GrayWolf8856/kyletechcorner-preview/projects/plant-hub/img/render-iso.png

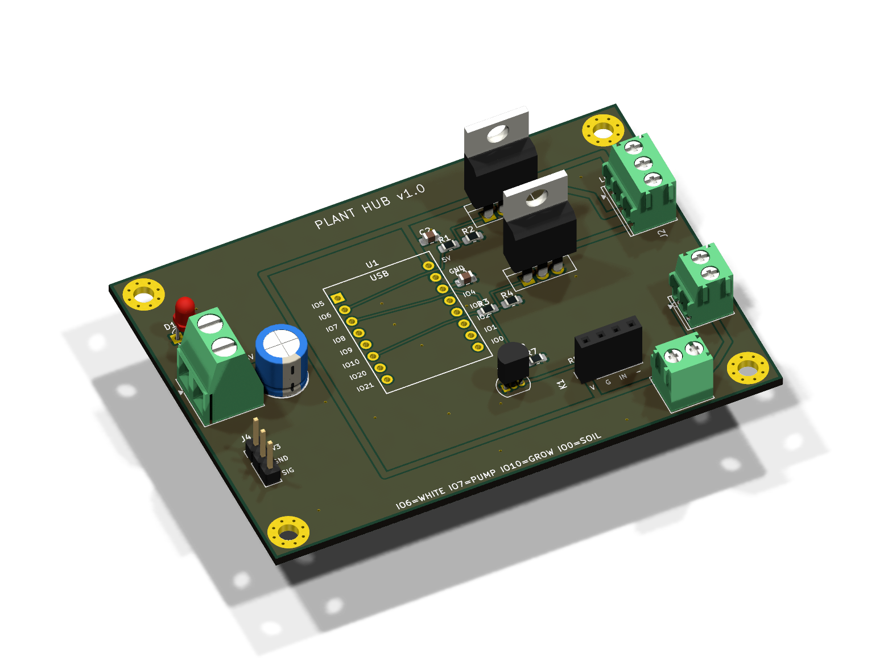
projects/plant-hub/img/render-iso.png
