GrayWolf8856/kyletechcorner-preview/projects/plant-hub/img/render-top.png

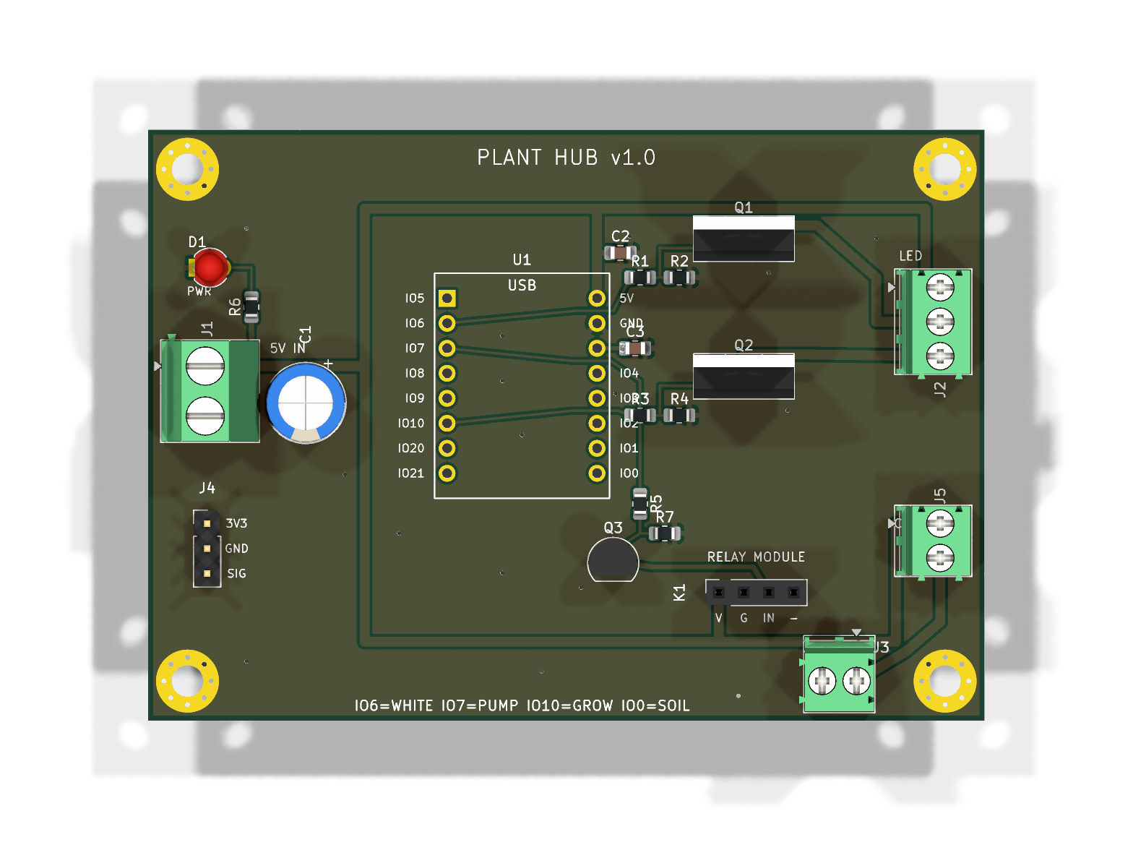
projects/plant-hub/img/render-top.png
