GrayWolf8856/kyletechcorner-preview/projects/plant-hub/files/plant-hub-v1.0-schematic.pdf

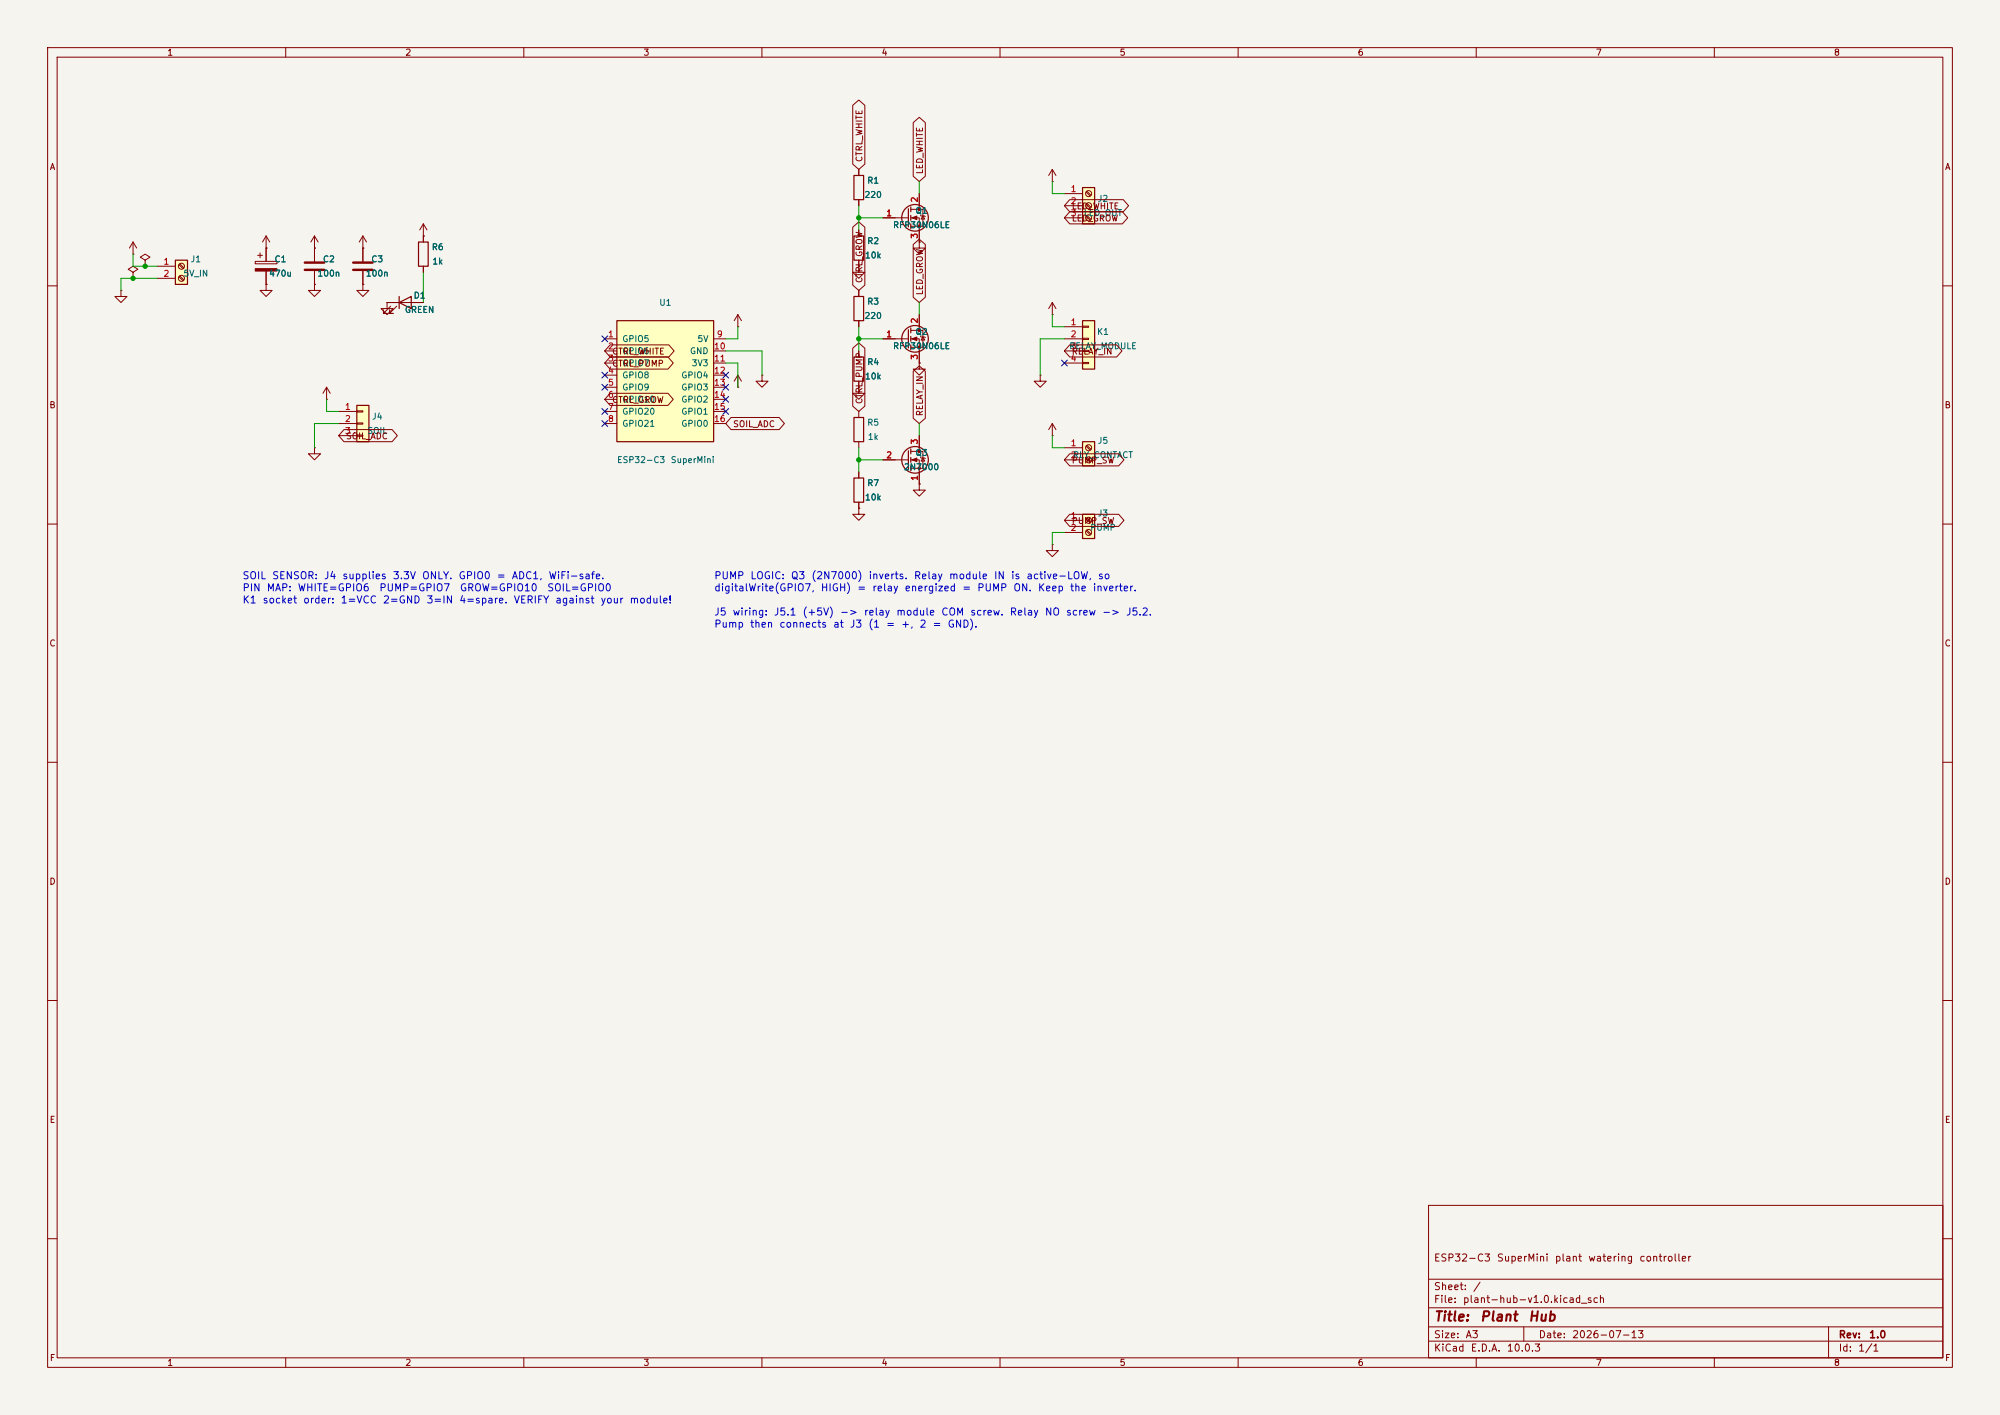
[picture p3: page 1]

LED_WHITE CTRL_PUMP PIN MAP: WHITE=GPIO6 PUMP=GPIO7 GROW=GPIO10 SOIL=GPIO0

K1 socket order: 1=VCC 2=GND 3=IN 4=spare. VERIFY against your module! C1

digitalWrite(GPIO7, HIGH) = relay energized = PUMP ON. Keep the inverter.

J5 wiring: J5.1 (+5V) -> relay module COM screw. Relay NO screw -> J5.2.
Pump then connects at J3 (1 = +, 2 = GND).

ESP32-C3 SuperMini plant watering controller

Size: A3 | Rev: 1.0 | F Date: 2026-07-13
KiCad E.D.A. 10.0.3 | Id: 1/1
