GrayWolf8856/kyletechcorner-preview/projects/plant-hub/hardware/kicad/plant-hub-v1.0.kicad_pcb

## KiCad design projects/plant-hub/hardware/kicad/plant-hub-v1.0.kicad_pcb (2026-07-13)

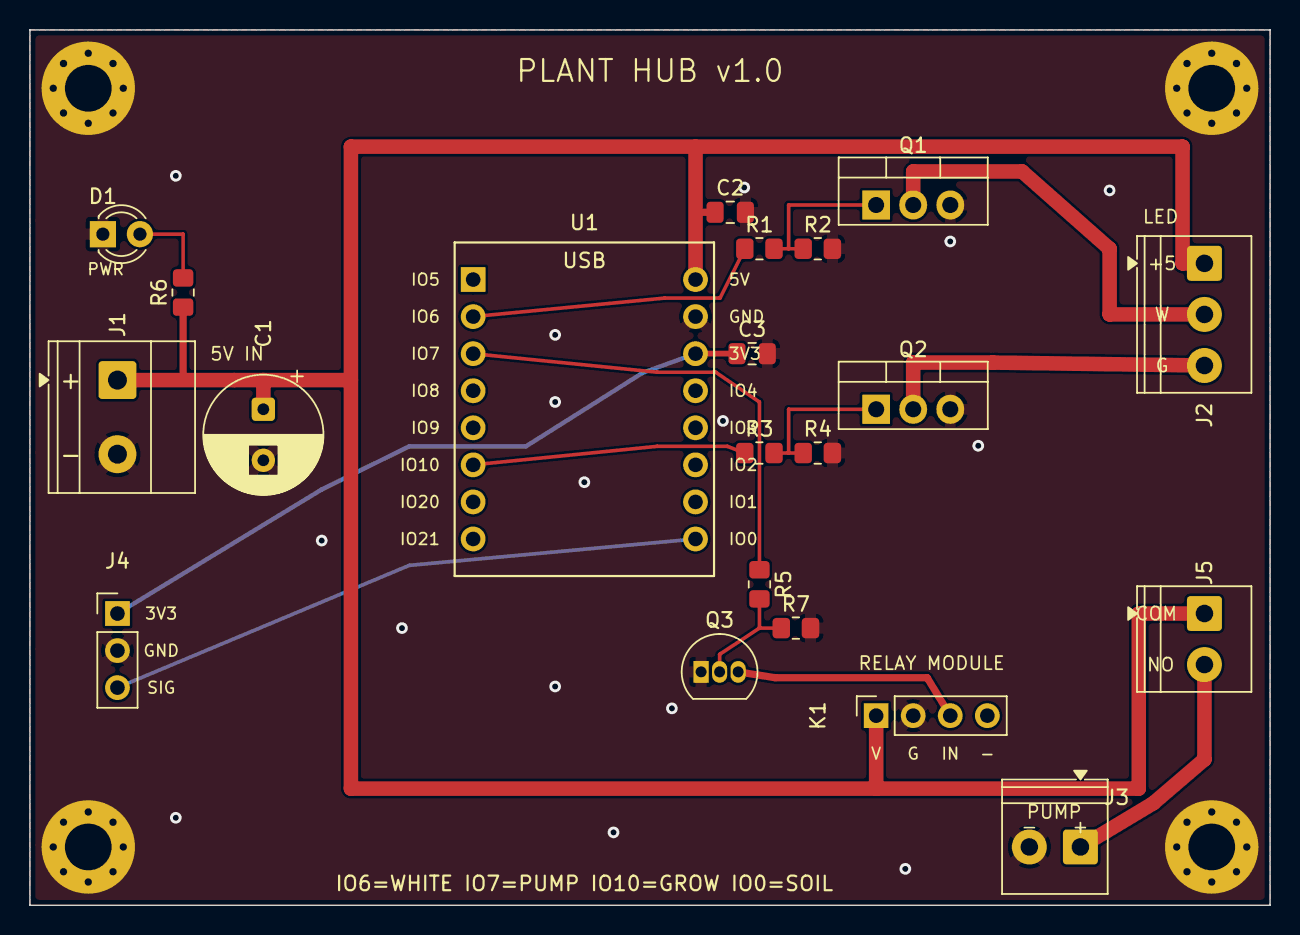
[picture p4: board plant-hub-v1.0.kicad_pcb from above]

Board: 2 copper layers, 85.0 x 60.0 mm, 25 parts (0 on the bottom side), 15 nets.

Parts:
C1: 470u; CP_Radial_D8.0mm_P3.50mm
C2, C3: 100n; C_0805_2012Metric_Pad1.18x1.45mm_HandSolder
D1: GREEN; LED_D3.0mm
H1, H2, H3, H4: M3; MountingHole_3.2mm_M3_Pad_Via
J1: 5V_IN; TerminalBlock_Phoenix_MKDS-1,5-2-5.08_1x02_P5.08mm_Horizont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
J2: LED_OUT; TerminalBlock_Phoenix_PT-1,5-3-3.5-H_1x03_P3.50mm_Horizontal
J3: PUMP; TerminalBlock_Phoenix_PT-1,5-2-3.5-H_1x02_P3.50mm_Horizontal
J4: SOIL; PinHeader_1x03_P2.54mm_Vertical
J5: RLY_CONTACT; TerminalBlock_Phoenix_PT-1,5-2-3.5-H_1x02_P3.50mm_Horizontal
K1: RELAY_MODULE; PinSocket_1x04_P2.54mm_Vertical
Q1, Q2: RFP30N06LE; TO-220-3_Vertical
Q3: 2N7000; TO-92_Inline
R1, R3: 220; R_0805_2012Metric_Pad1.20x1.40mm_HandSolder
R2, R4, R7: 10k; R_0805_2012Metric_Pad1.20x1.40mm_HandSolder
R5, R6: 1k; R_0805_2012Metric_Pad1.20x1.40mm_HandSolder
U1: ESP32-C3 SuperMini; ESP32-C3-SuperMini-Socket

Connections:
+3V3: C3.1, J4.1, U1.11
+5V: C1.1, C2.1, J1.1, J2.1, J5.1, K1.1, R6.1, U1.9
CTRL_GROW: R3.1, U1.6
CTRL_PUMP: R5.1, U1.3
CTRL_WHITE: R1.1, U1.2
GND: C1.2, C2.2, C3.2, D1.1, H1.1, H2.1, H3.1, H4.1, J1.2, J3.2, J4.2, K1.2, Q1.3, Q2.3, Q3.1, R2.2, R4.2, R7.2, U1.10
G_GROW: Q2.1, R3.2, R4.1
G_PUMP: Q3.2, R5.2, R7.1
G_WHITE: Q1.1, R1.2, R2.1
LED_GROW: J2.3, Q2.2
LED_WHITE: J2.2, Q1.2
PUMP_SW: J3.1, J5.2
PWR_LED: D1.2, R6.2
RELAY_IN: K1.3, Q3.3
SOIL_ADC: J4.3, U1.16
